INSA-GEI/arm-ada/hardware/Altium-PCB/PCB_Hammond_1591GSGY-v3.PcbDoc.htm

Reporting Options

# File in Previous Format

Date | : | 04/06/2014
Time | : | 15:26:00
Filename | : | D:\Utilisateurs\sd\Mes documents\SVN\arm-ada\Altium-PCB\PCB_Hammond_1591GSGY-v3.PcbDoc

Version | Warning
Release 13 | CAUTION - Silkscreen Over Component Pads Rules are converted to Silk To Solder Mask Clearance Rules. Suggest examining rule scopes for accuracy.
Release 14 | CAUTION - The Differential Pairs Routing rule added support for control of the width. Be aware that Width rules pertaining to differential pairs need to be manually moved to the Differential Pairs Routing rule.

This file was generated by an earlier version of the software
