INSA-GEI/arm-ada/hardware/Altium-PCB/PCB_Hammond_1591GSGY-v2.pdf

100nF | CAP 100nF 16V -20% to +80% 1206 (3216 Metric) Thickness 1mm SMD
1µF | CAP Polarized Tantalum 1µF 3216-18 A
47µF | CAP Polarized Tantalum 47µF 7343-31 D
NDT-03C | Audio HP
SKQUCAA010 | 4 ways + center switch
SPST MicroSwitch | SPST - MicroSwitch
JTAG-10 | 10 way JTAG connector
440247-1 | USB 2.0, Right Angle, SMT, B Type, Receptacle, 5 Position, Black
DM3D-SF | Micro SD card Connector
Inductor | Inductor SMD
POT Type 51 | 25mm Diameter potentiometer
Led | OSRAM LO Q971 Orange
470R
10K | Resistor 10K 0.25W 1% 1206 (3216 Metric) SMD
1K | Resistor 1K 0.25W 1% 1206 (3216 Metric) SMD
22K | Resistor 22K 0.25W 1% 1206 (3216 Metric) SMD
22R | Resistor 22R 0.25W 1% 1206 (3216 Metric) SMD
47K | Resistor 47K 0.25W 1% 1206 (3216 Metric) SMD
1,5K | Resistor 1,5K 0.25W 1% 1206 (3216 Metric) SMD
Not Populated | Resistor 0R 0.25W 1% 1206 (3216 Metric) SMD
TestPoint | TestPoint SMD
STM32F3-DISCOVERY | STM32F3-Discovery Connectors
INT024BTFT | INT024BTFT Connectors
AS64C4008 | SRAM 4Mbits 512K*8Bits 55 ns
TS4990 | TS4990
STM32F102C4T6A | STM32 ARM-based 32-bit MCU Performance Line with 16 kB Flash, 6 kB Internal RAM, Internal Code A, -40 to +85°C Temperature, 48-Pin LQFP, Tray
XC6214 | Fixed LDO regulator
HC49/4H_SMX | Surface Mount Quartz Crystal

Resistor 470R 0,25W 1 % 1206 (3216 Metric) SMD

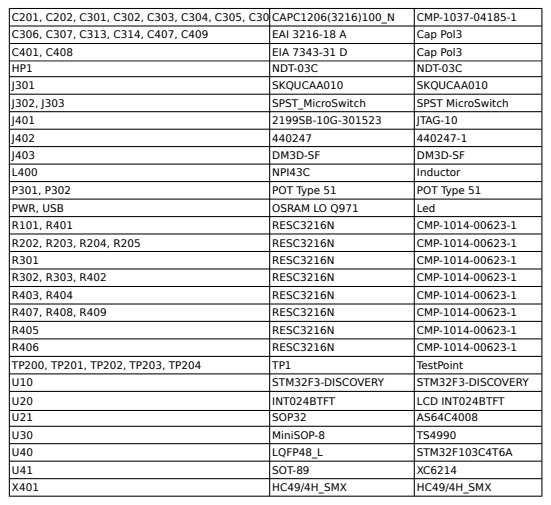
[picture p4: page 2]

18 | KEMET | C1206C104M5RACTU | FARNELL | 1671445
6 | KEMET | B45196H5105K109 | FARNELL | 9753958
2 | KEMET | B45196E1476K409 | FARNELL | 9753770
1 | STAR MICRONICS | NDT-03C | FARNELL | 1299760
1 | ALPS | SKQUCAA010 | RADIOSPARES | 516-316
2 | TE Connectivity | FSM2JH | RADIOSPARES | 479-1390
1 | FCI | 20021121-00010C4LF | FARNELL | 1865279
1 | Molex | 67503-1020 | RADIOSPARES | 666-1099
1 | Hirose | DM3D-SF | RADIOSPARES | 738-8809
1 | NIC Components | NPI43C680MTRF | RADIOSPARES | 740-9429
2 | TE Connectivity | 5150500306 | RADIOSPARES | 393-790P
2 | OSRAM | LO Q971 | RADIOSPARES | 654-5789
2 | YAGEO | RC1206JR-07470RL | FARNELL | 1799533
4 | YAGEO | RC1206JR-0710KL | FARNELL | 2131811
1 | YAGEO | RC1206JR-071KL | FARNELL | 1799519
3 | PANASONIC | ERJ-8GEYJ223V | FARNELL | 2395314
2 | PANASONIC | ERJ-8GEYJ220V | FARNELL | 2395311
3 | PANASONIC | ERJ-8GEYJ473V | FARNELL | 2395337
1 | PANASONIC | ERJ-8GEYJ152V | FARNELL | 2395298
1 | Not populated | Not populated | Not populated | Not populated
5 | N/A | N/A | N/A | N/A
2 | SAMTEC | CES-125-01-T-D | FARNELL | 1667528
2 | SAMTEC | SLW-112-01-G-S | FARNELL | 1668103
1 | ALLIANCE MEMORY | AS6C4008-55SIN | FARNELL | 1562901
1 | STMICROELECTRONICS | TS4990IST | FARNELL | 1750137
1 | STMICROELECTRONICS | STM32F102C4T6A | RADIOSPARES | 723-8956
1 | TOREX | XC6214P332PR | FARNELL | 1698269
1 | TXC | 9C-8.000MEEJ-T | FARNELL | 1842347
