INSA-GEI/arm-ada/docs/Devis - Estimations/Weerg - 50.pdf

€ 2.577,67 (VAT included)
Any customs duties not included

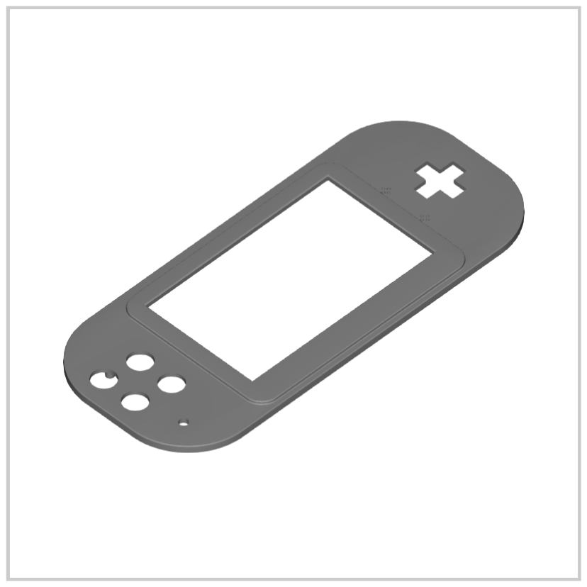
[picture p13: figure]

Partie Haute
DIMENSIONS: 85,00X14,00X200,00mm DELIVERY: mer 10/07/2019
SERVICE STAMPA3D
QUANTITY 50
€ 17,79

Partie basse-slim
DIMENSIONS: 85,00X28,00X200,00mm DELIVERY: mer 10/07/2019
SERVICE STAMPA3D
QUANTITY 50
€ 33,37

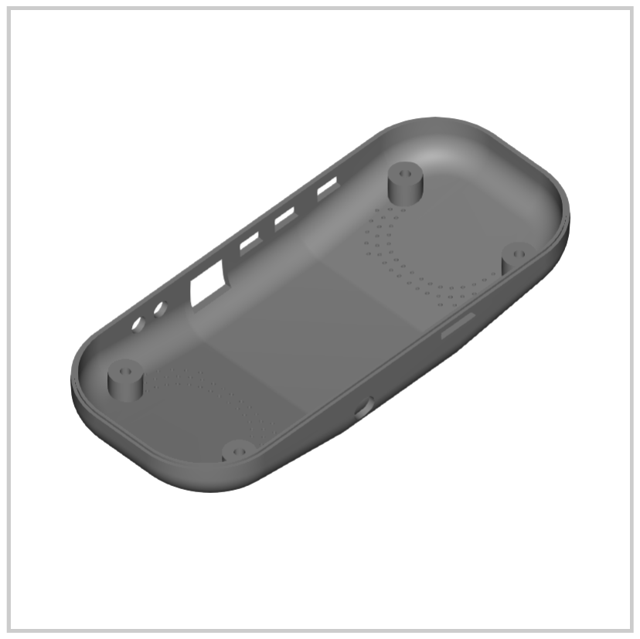
[picture p14: figure]

TOT PRODUCTS | € 2.096,39
Delivery country | FR
TOT DELIVERY DELIV NUM: 1 | € 16,45
TOT NO VAT | € 2.112,84
TOT VAT | € 464,83
TOT.

€ 2.577,67

VALID UNTIL: 25/07/2019
