INSA-GEI/arm-ada/docs/Documentation-technique.odt

Documentation technique

Sébastien DI MERCURIO

1.0

Sommaire

# Présentation

ARM-ADA est un projet composé d’un compilateur et d’un boitier

# Le boîtier « GameBoy »

Un peu de blabla

## Localisation mémoire du bootloader

Stack Data + BSS Buffer USART Code Reservé Le bootloader utilise la mémoire de la façon suivante :

0x10000000

0x10000400

0x10002000

0x20000000

0x2000A000

0x08000000

0x08003000

0x080A0000

0x10001FFC

Données partagées (reboot)

FLASH

RAM

## Localisation mémoire du système

Le système utilise la mémoire de la façon suivante :

Stack Data + BSS Buffer USART Code Reservé

0x10000000

0x10000400

0x10002000

0x20000000

0x2000A000

0x08000000

0x08003000

0x080A0000

0x10001FFC

Données partagées (reboot)

FLASH

RAM

## fdvd

2 - Documentation technique - 1.0

- Documentation technique - 1.0 5
