INSA-GEI/arm-ada/firmware/CubeIDE/System/ressources/INSA_cadrage_serre.jpg

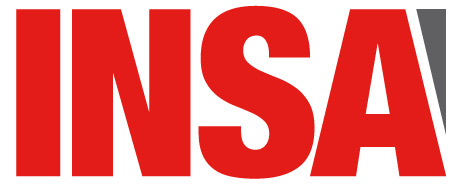
firmware/CubeIDE/System/ressources/INSA_cadrage_serre.jpg
