INSA-GEI/arm-ada/hardware/Altium-PCB/Bill of Material.ods

Composant | Fournisseur | Ref Fournisseur | Ref fabriquant | Prix unitaire | Quantité | Sous Total
Connecteurs STM32F3-Discovery | Farnell | 166-7528 | CES-125-01-T-D | 2.64 | 2
Connecteurs Ecran LCD femelle | Farnell | 166-8103 | SLW-112-01-G-S | 1.93 | 2
Haut Parleur | Farnell | 129-9760 | NDT-03C | 3.19 | 1
RAM | Farnell | 1562901 | AS6C4008-55SIN | 2.72 | 1
Potentiometres | Farnell | 117-4445 | 5150500307 | 1.18 | 2
Bouton potentiometre | Farnell | 748330 | 5904620121 | 0.8 | 2
Connecteurs Ecran LCD male | Farnell | 203-5399 | TSW-112-06-T-S | 0.763 | 2
Connecteur debug | Farnell | 186-5279 | 20021121-00010C4LF | 0.84 | 1
Ampli audio | Farnell | 175-0137 | TS4990IST | 0.54 | 1
Quartz | Farnell | 1842347 | TXC - 9C-8.000MEEJ-T | 0.32 | 1
Bouton | Radiospares | 479-1390 | FSM2JH | 0.1 | 2
Regulateur 3,3V | Farnell | 1698269 | XC6214P332PR | 0.36 | 1
Écran LCD | Radiospares | 740-6008 | INT24BTFT | 31.185 | 1
STM32F3-Discovery | Radiospares | 769-2091 | STM32F3-Discovery | 10.044 | 1
Boitier | Radiospares | 493-6183 | 1590GGY | 4.527 | 1
STM32F102C4T6A | Radiospares | 723-8956 | STM32F102C4T6A | 2.223 | 1
Bouton 5 directions | Radiospares | 516-316 | SKQUCAA010 | 1.728 | 1
Connecteur MicroSD | Radiospares | 738-8809 | DM3D-SF | 1.012 | 1
Connecteur Mini USB | Radiospares | 666-1099 | 67503-1020 | 0.421 | 1
Entretoises PVC | Radiospares | 265-2170 |  |  | 4
Vis LCD | Radiospares | 482-7887 |  |  | 4
Led | Radiospares | 654-5789 | LO Q971 | 0.038 | 2
Vis PCB | Radiospares | 482-8262 |  |  | 4
Inductance CMS 68µH | Radiospares | 740-9429 | NPI43C680MTRF | 0.184 | 1
Ecrous LCD | Radiospares | 248-4567 |  |  | 4
Rondelles LCD | Radiospares | 289-073 |  |  | 4
PCB | PCB_Pool |  |  | 6.5 | 1
 |  |  |  |  | Total HT =>
 |  |  |  |  | TVA
 |  |  |  |  | Total TTC =>
