INSA-GEI/arm-ada/hardware/Altium-PCB/PCB_Hammond_1591GSGY-v2.xls

Comment | Description | Designator | Footprint | LibRef | Quantity | Manufacturer | Manufacturer Ref | Distributor | Distributor Ref
100nF | CAP 100nF 16V -20% to +80% 1206 (3216 Metric) Thickness 1mm SMD | C201, C202, C301, C302, C303, C304, C305, C308, C309, C310, C311, C312, C402, C403, C404, C405, C406, C410 | CAPC1206(3216)100_N | CMP-1037-04185-1 | 18 | KEMET | C1206C104M5RACTU | FARNELL | 1671445
1µF | CAP Polarized Tantalum 1µF 3216-18 A | C306, C307, C313, C314, C407, C409 | EAI 3216-18 A | Cap Pol3 | 6 | KEMET | B45196H5105K109 | FARNELL | 9753958
47µF | CAP Polarized Tantalum 47µF 7343-31 D | C401, C408 | EIA 7343-31 D | Cap Pol3 | 2 | KEMET | B45196E1476K409 | FARNELL | 9753770
NDT-03C | Audio HP | HP1 | NDT-03C | NDT-03C | 1 | STAR MICRONICS | NDT-03C | FARNELL | 1299760
SKQUCAA010 | 4 ways + center switch | J301 | SKQUCAA010 | SKQUCAA010 | 1 | ALPS | SKQUCAA010 | RADIOSPARES | 516-316
SPST MicroSwitch | SPST - MicroSwitch | J302, J303 | SPST_MicroSwitch | SPST MicroSwitch | 2 | TE Connectivity | FSM2JH | RADIOSPARES | 479-1390
JTAG-10 | 10 way JTAG connector | J401 | 2199SB-10G-301523 | JTAG-10 | 1 | FCI | 20021121-00010C4LF | FARNELL | 1865279
440247-1 | USB 2.0, Right Angle, SMT, B Type, Receptacle, 5 Position, Black | J402 | 440247 | 440247-1 | 1 | Molex | 67503-1020 | RADIOSPARES | 666-1099
DM3D-SF | Micro SD card Connector | J403 | DM3D-SF | DM3D-SF | 1 | Hirose | DM3D-SF | RADIOSPARES | 738-8809
Inductor | Inductor SMD | L400 | NPI43C | Inductor | 1 | NIC Components | NPI43C680MTRF | RADIOSPARES | 740-9429
POT Type 51 | 25mm Diameter potentiometer | P301, P302 | POT Type 51 | POT Type 51 | 2 | TE Connectivity | 5150500306 | RADIOSPARES | 393-790P
Led | OSRAM LO Q971 Orange | PWR, USB | OSRAM LO Q971 | Led | 2 | OSRAM | LO Q971 | RADIOSPARES | 654-5789
470R | Resistor 470R 0,25W 1 % 1206 (3216 Metric) SMD | R101, R401 | RESC3216N | CMP-1014-00623-1 | 2 | YAGEO | RC1206JR-07470RL | FARNELL | 1799533
10K | Resistor 10K 0.25W 1% 1206 (3216 Metric) SMD | R202, R203, R204, R205 | RESC3216N | CMP-1014-00623-1 | 4 | YAGEO | RC1206JR-0710KL | FARNELL | 2131811
1K | Resistor 1K 0.25W 1% 1206 (3216 Metric) SMD | R301 | RESC3216N | CMP-1014-00623-1 | 1 | YAGEO | RC1206JR-071KL | FARNELL | 1799519
22K | Resistor 22K 0.25W 1% 1206 (3216 Metric) SMD | R302, R303, R402 | RESC3216N | CMP-1014-00623-1 | 3 | PANASONIC | ERJ-8GEYJ223V | FARNELL | 2395314
22R | Resistor 22R 0.25W 1% 1206 (3216 Metric) SMD | R403, R404 | RESC3216N | CMP-1014-00623-1 | 2 | PANASONIC | ERJ-8GEYJ220V | FARNELL | 2395311
47K | Resistor 47K 0.25W 1% 1206 (3216 Metric) SMD | R407, R408, R409 | RESC3216N | CMP-1014-00623-1 | 3 | PANASONIC | ERJ-8GEYJ473V | FARNELL | 2395337
1,5K | Resistor 1,5K 0.25W 1% 1206 (3216 Metric) SMD | R405 | RESC3216N | CMP-1014-00623-1 | 1 | PANASONIC | ERJ-8GEYJ152V | FARNELL | 2395298
Not Populated | Resistor 0R 0.25W 1% 1206 (3216 Metric) SMD | R406 | RESC3216N | CMP-1014-00623-1 | 1 | Not populated | Not populated | Not populated | Not populated
TestPoint | TestPoint SMD | TP200, TP201, TP202, TP203, TP204 | TP1 | TestPoint | 5 | N/A | N/A | N/A | N/A
STM32F3-DISCOVERY | STM32F3-Discovery Connectors | U10 | STM32F3-DISCOVERY | STM32F3-DISCOVERY | 2 | SAMTEC | CES-125-01-T-D | FARNELL | 1667528
INT024BTFT | INT024BTFT Connectors | U20 | INT024BTFT | LCD INT024BTFT | 2 | SAMTEC | SLW-112-01-G-S | FARNELL | 1668103
AS64C4008 | SRAM 4Mbits 512K*8Bits 55 ns | U21 | SOP32 | AS64C4008 | 1 | ALLIANCE MEMORY | AS6C4008-55SIN | FARNELL | 1562901
TS4990 | TS4990 | U30 | MiniSOP-8 | TS4990 | 1 | STMICROELECTRONICS | TS4990IST | FARNELL | 1750137
STM32F102C4T6A | STM32 ARM-based 32-bit MCU Performance Line with 16 kB Flash, 6 kB Internal RAM, Internal Code A, -40 to +85°C Temperature, 48-Pin LQFP, Tray | U40 | LQFP48_L | STM32F103C4T6A | 1 | STMICROELECTRONICS | STM32F102C4T6A | RADIOSPARES | 723-8956
XC6214 | Fixed LDO regulator | U41 | SOT-89 | XC6214 | 1 | TOREX | XC6214P332PR | FARNELL | 1698269
HC49/4H_SMX | Surface Mount Quartz Crystal | X401 | HC49/4H_SMX | HC49/4H_SMX | 1 | TXC | 9C-8.000MEEJ-T | FARNELL | 1842347
