INSA-GEI/arm-ada/hardware/Altium-PCB/Meca/1591G Lid.stp

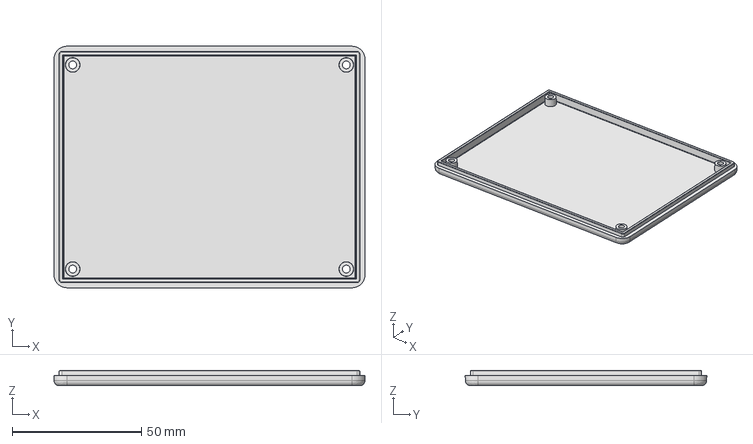
[picture p34: CAD file, 2021-03-29]
hardware/Altium-PCB/Meca/1591G Lid.stp
120.5 x 93.6 x 6.00 mm
