INSA-GEI/arm-ada/hardware/Altium-PCB/Meca/pcb.stp

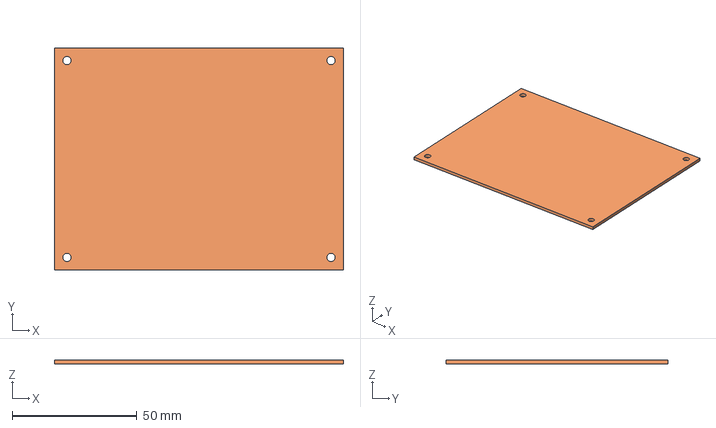
[picture p35: CAD file, 2021-03-29]
hardware/Altium-PCB/Meca/pcb.stp
116.0 x 89.0 x 1.60 mm
