INSA-GEI/arm-ada/hardware/Altium-PCB/Meca/1591G Box.stp

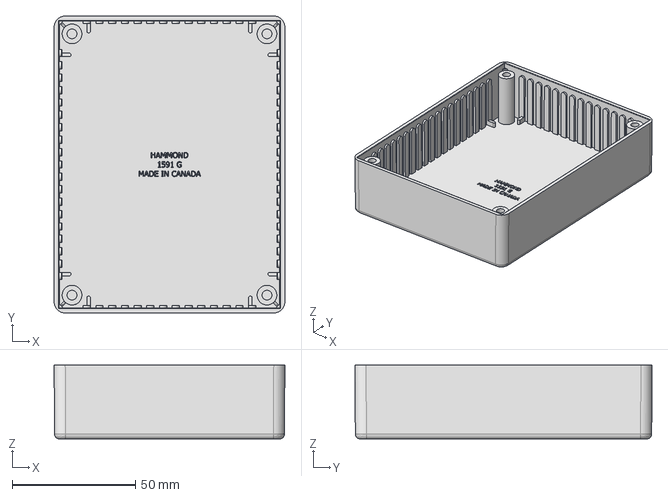
[picture p36: CAD file, 2021-03-29]
hardware/Altium-PCB/Meca/1591G Box.stp
93.6 x 120.5 x 30.0 mm
