INSA-GEI/arm-ada/(list of files, cad)

Other CAD files:
hardware/Altium-PCB/Meca/1591G Box.igs
hardware/Altium-PCB/Meca/1591G Box.ipt
hardware/Altium-PCB/Meca/1591G Lid.igs
hardware/Altium-PCB/Meca/Boitier + PCB.iam
hardware/Altium-PCB/Meca/Boitier.ipt
hardware/Altium-PCB/Meca/Composants importés/1591G Box/1591G Box.ipt
hardware/Altium-PCB/Meca/Insert.ipt
hardware/Altium-PCB/Meca/OldVersions/Boitier + PCB.0001.iam
hardware/Altium-PCB/Meca/OldVersions/Boitier.0001.ipt
hardware/Altium-PCB/Meca/OldVersions/Insert.0001.ipt
hardware/Altium-PCB/Meca/OldVersions/pcb.0002.ipt
hardware/Altium-PCB/Meca/boitier.iam
hardware/Altium-PCB/Meca/pcb.dwg
hardware/Altium-PCB/Meca/pcb.idw
hardware/Altium-PCB/Meca/pcb.ipt
