INSA-GEI/arm-ada/hardware/Altium-PCB/Ada4Arm.pdf

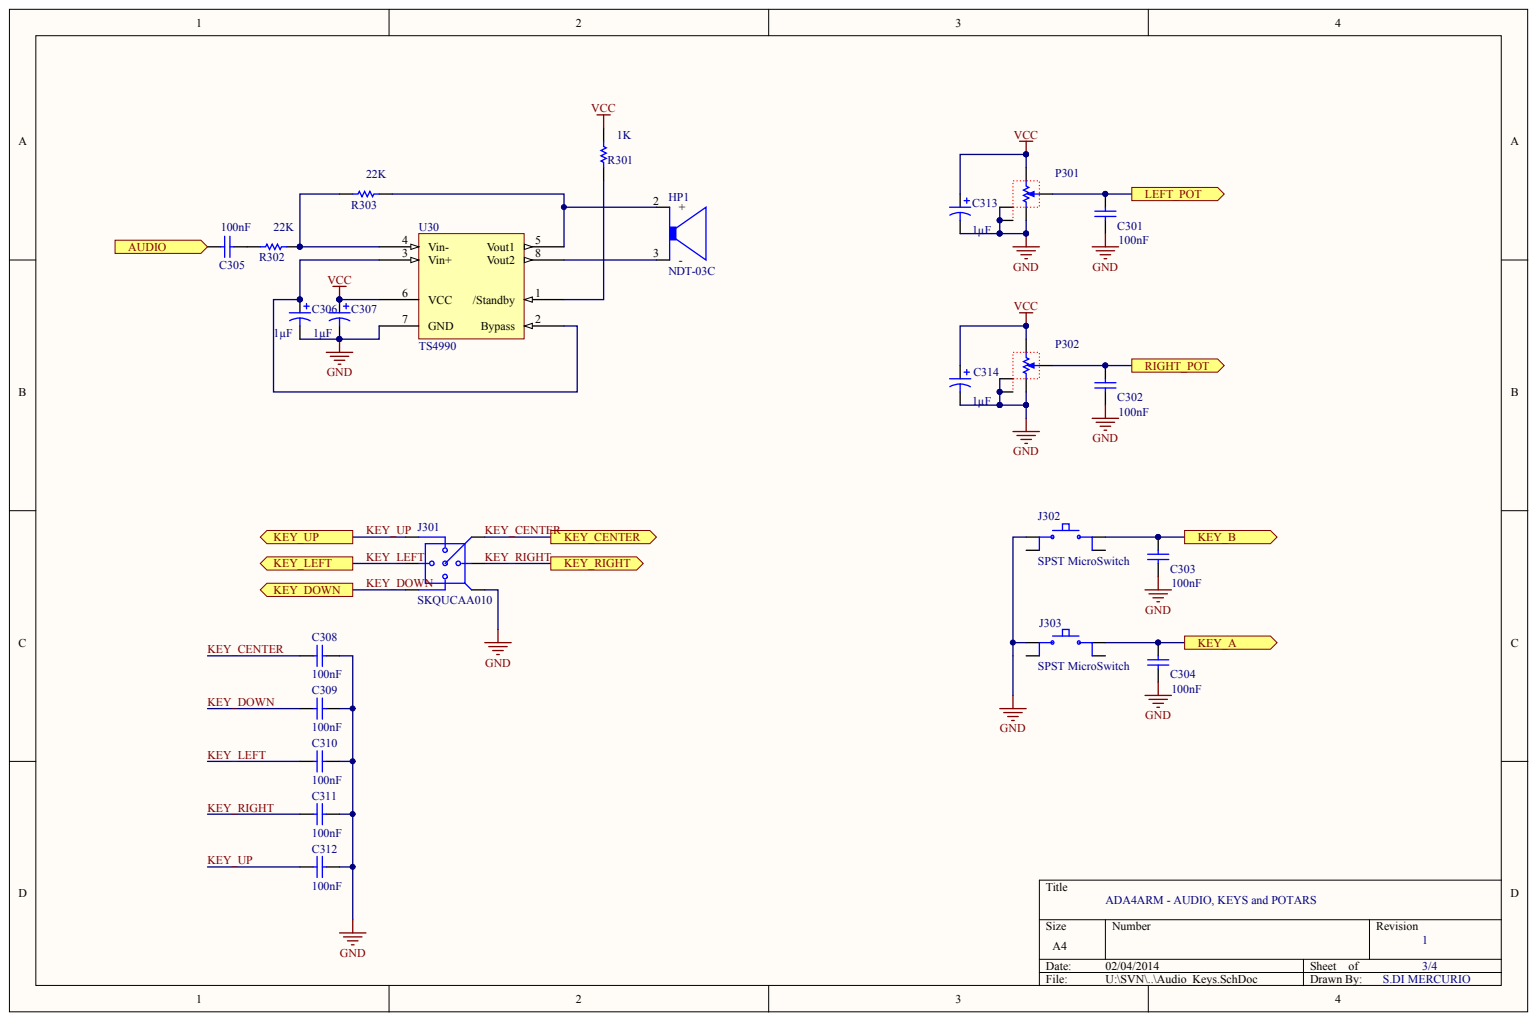
[picture p37: page 1]

ADA4ARM - AUDIO, KEYS and POTARS

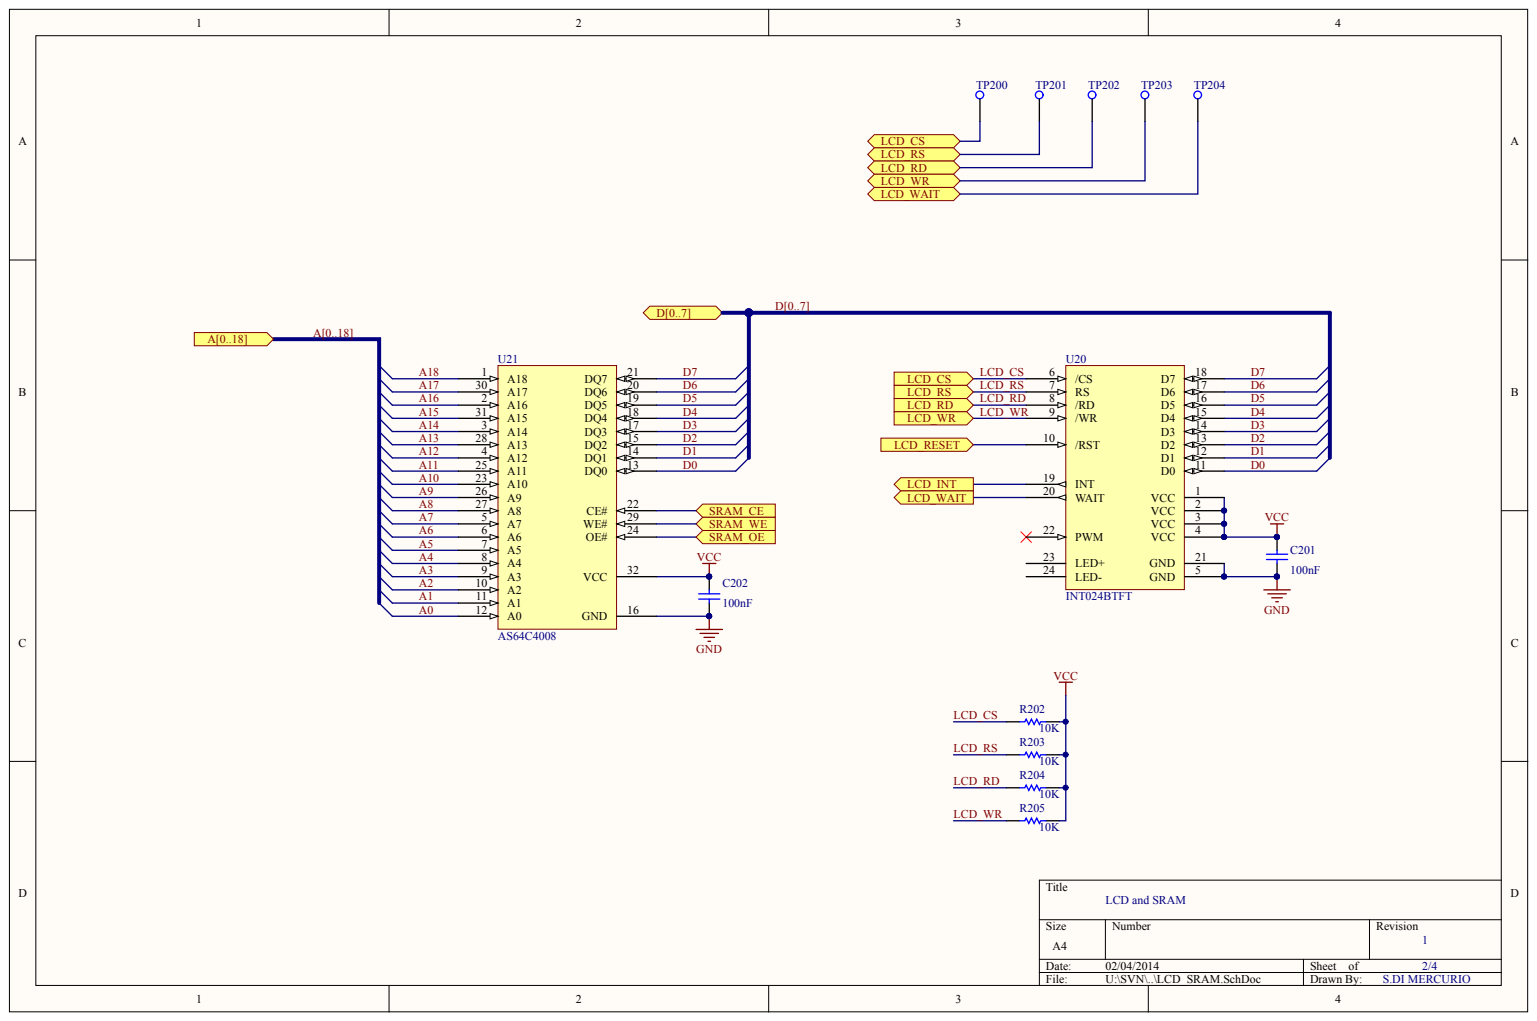
[picture p38: page 2]

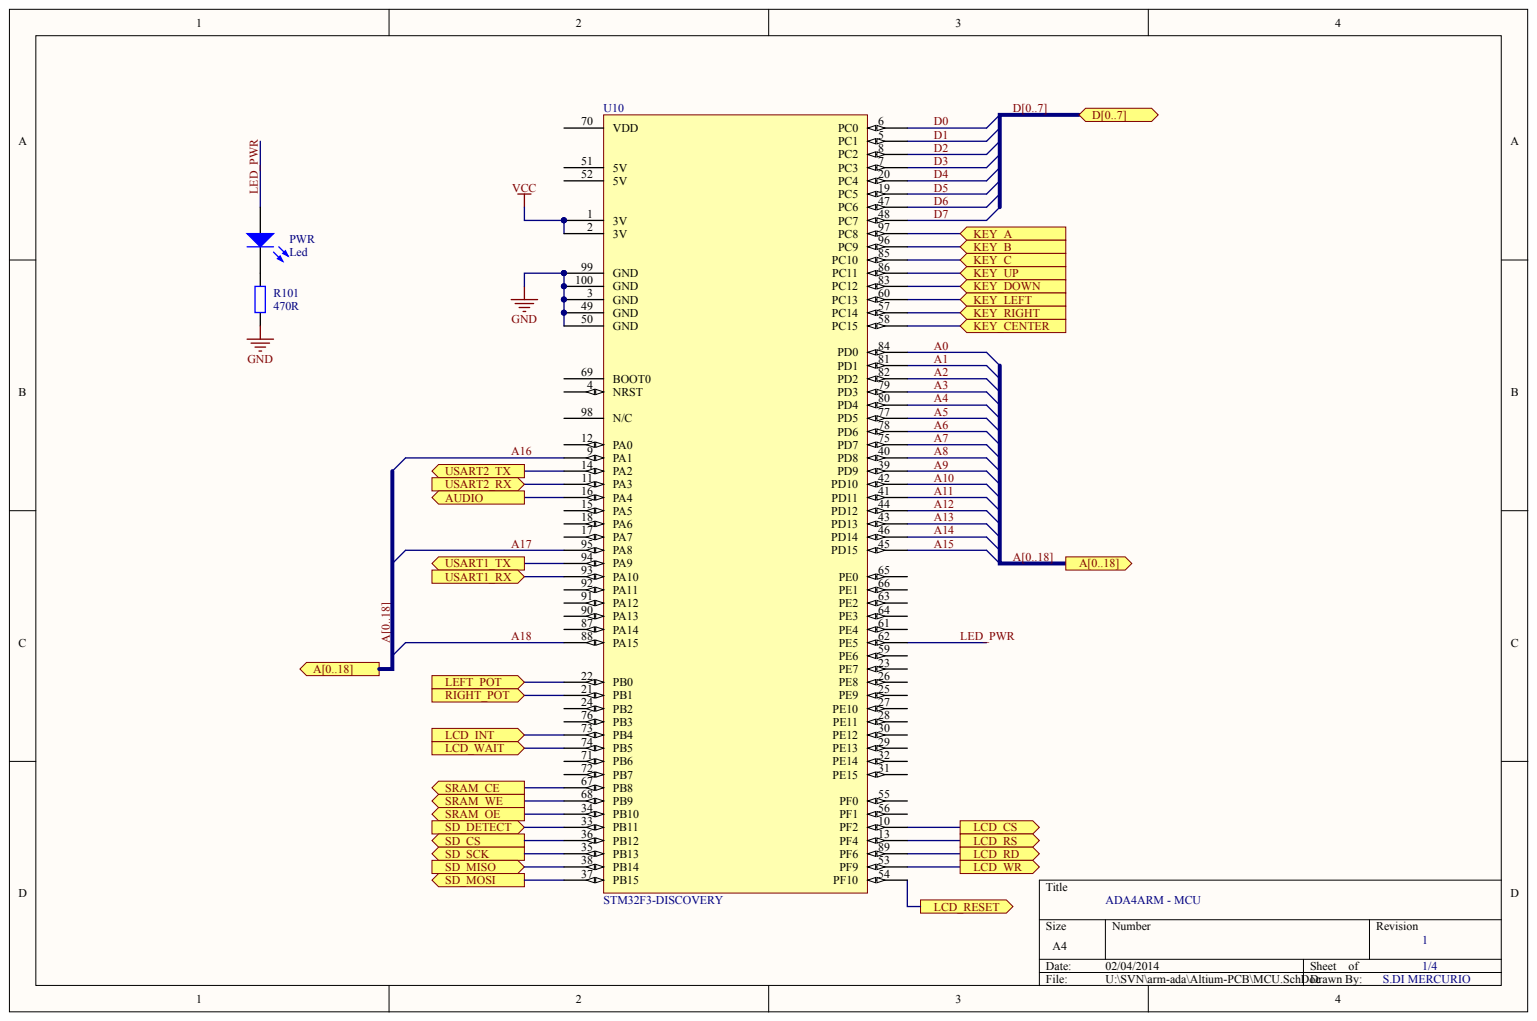
[picture p39: page 3]

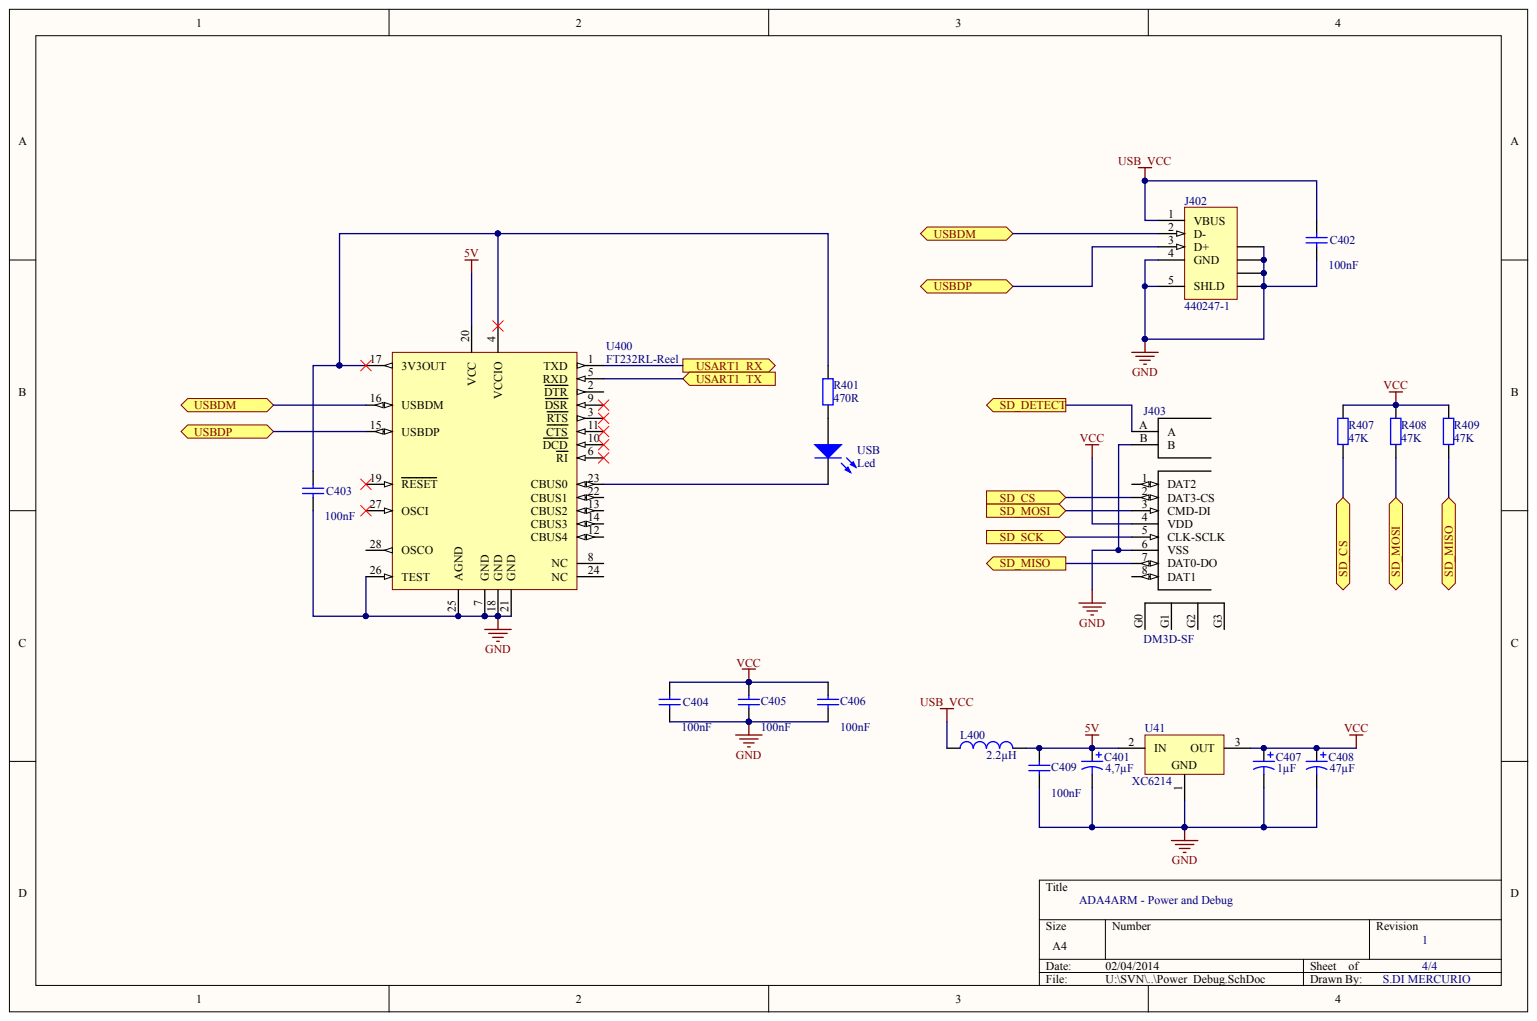
[picture p40: page 4]

4 | GND SHLD

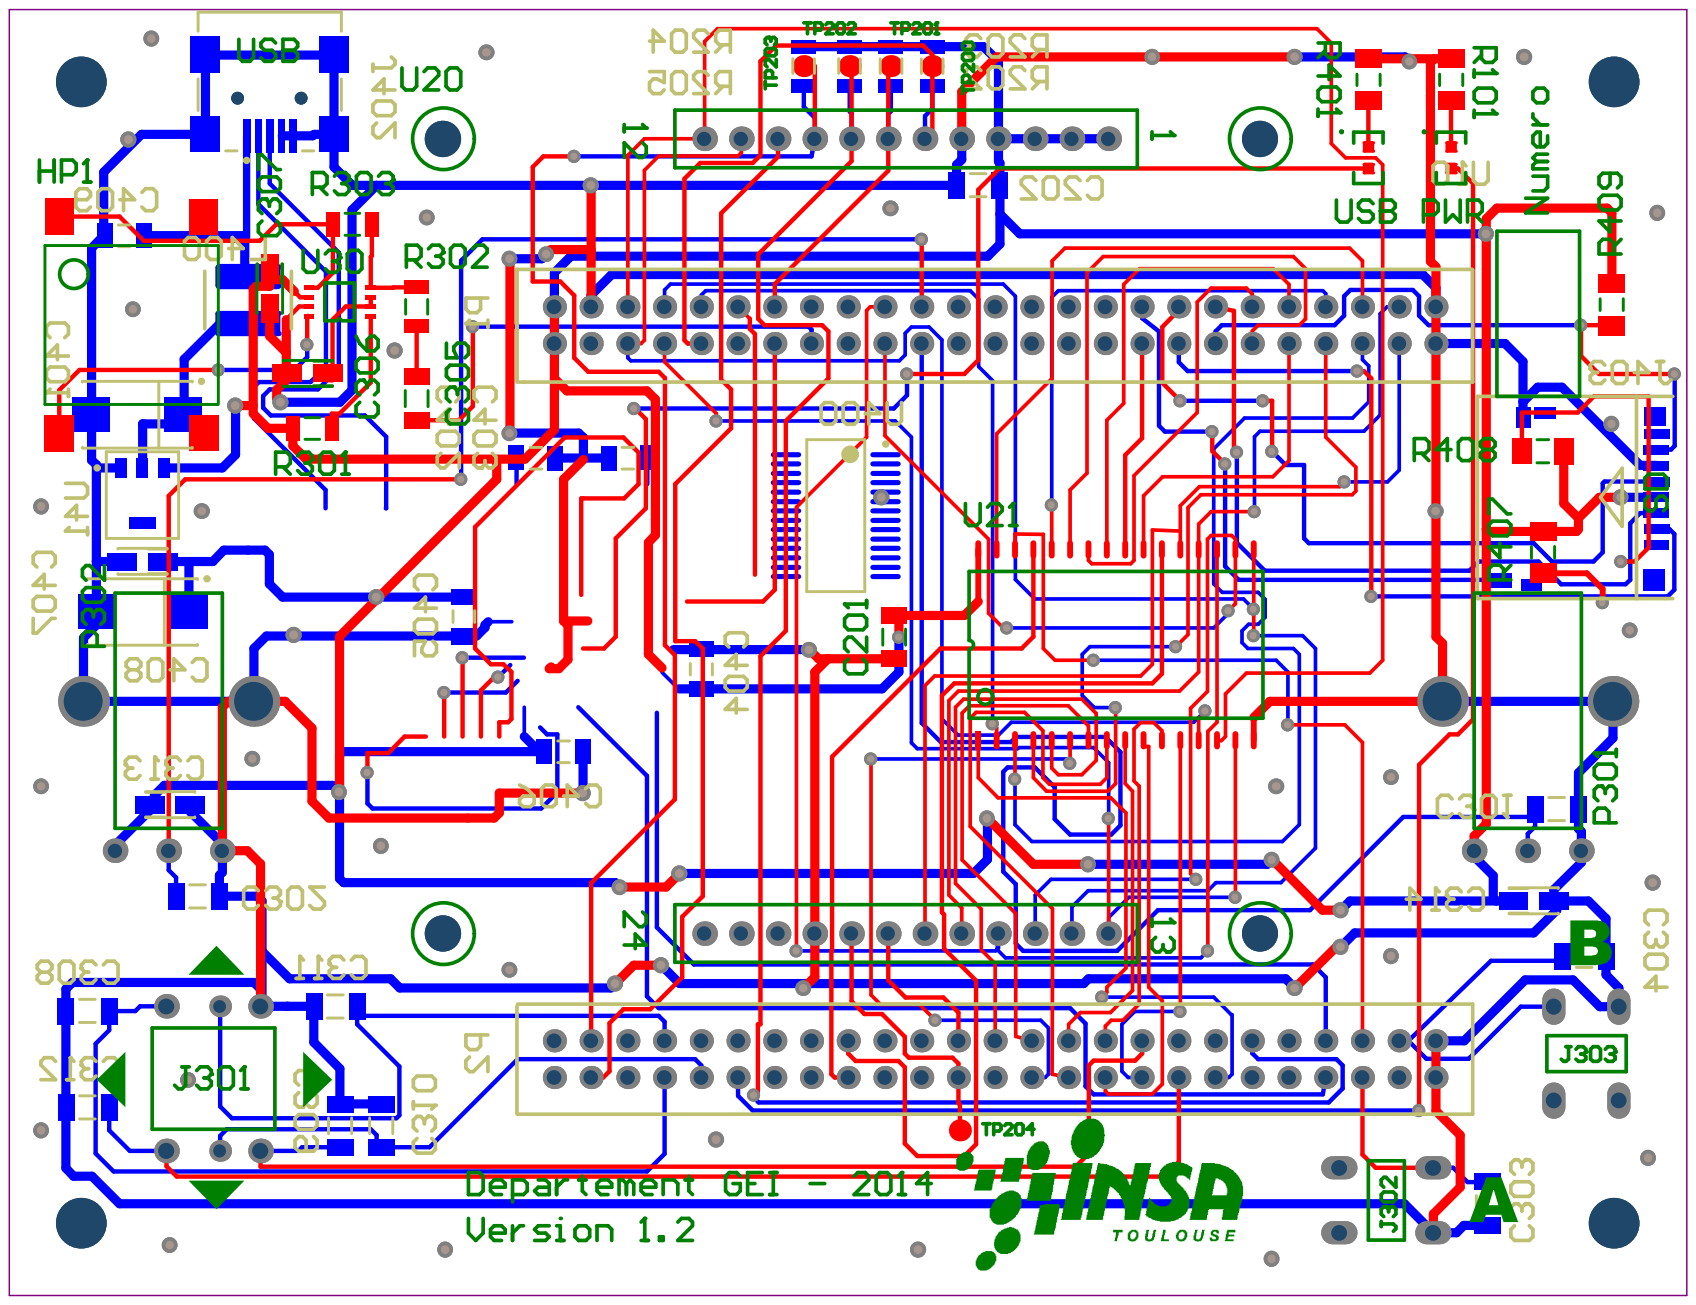
[picture p41: page 5]
