INSA-GEI/arm-ada/hardware/Altium-PCB/PCB_Hammond_1591GSGY.PDF

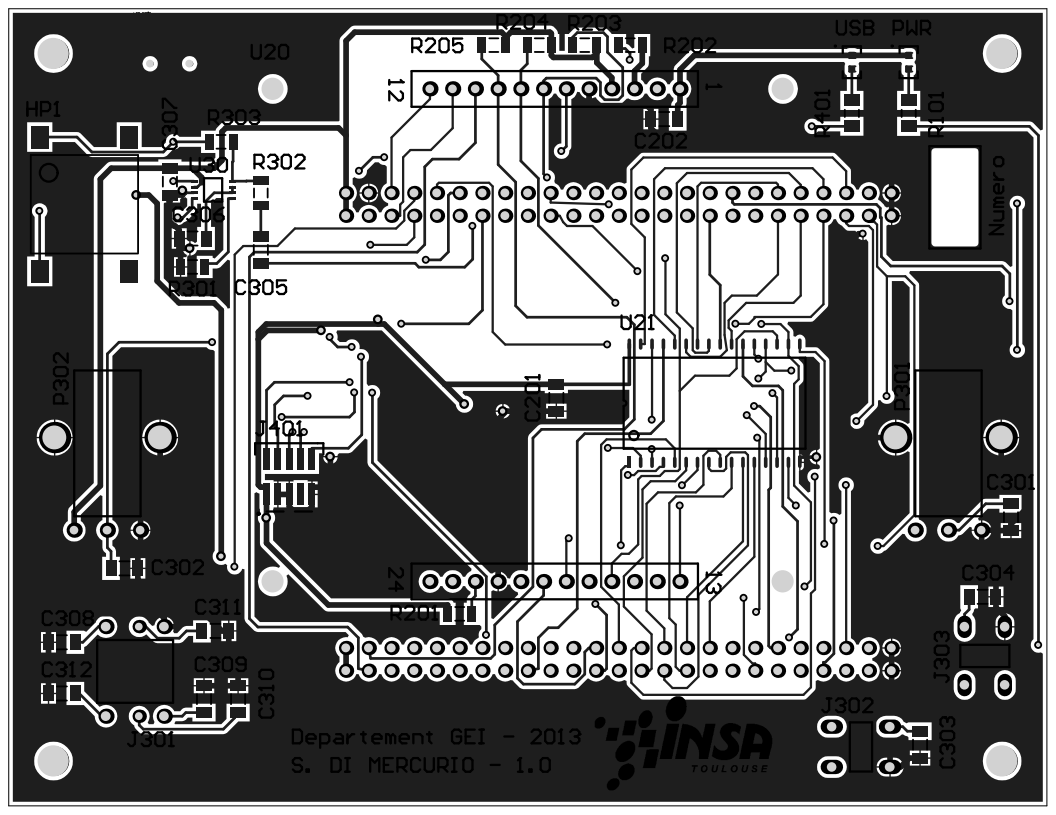
[picture p42: page 1]

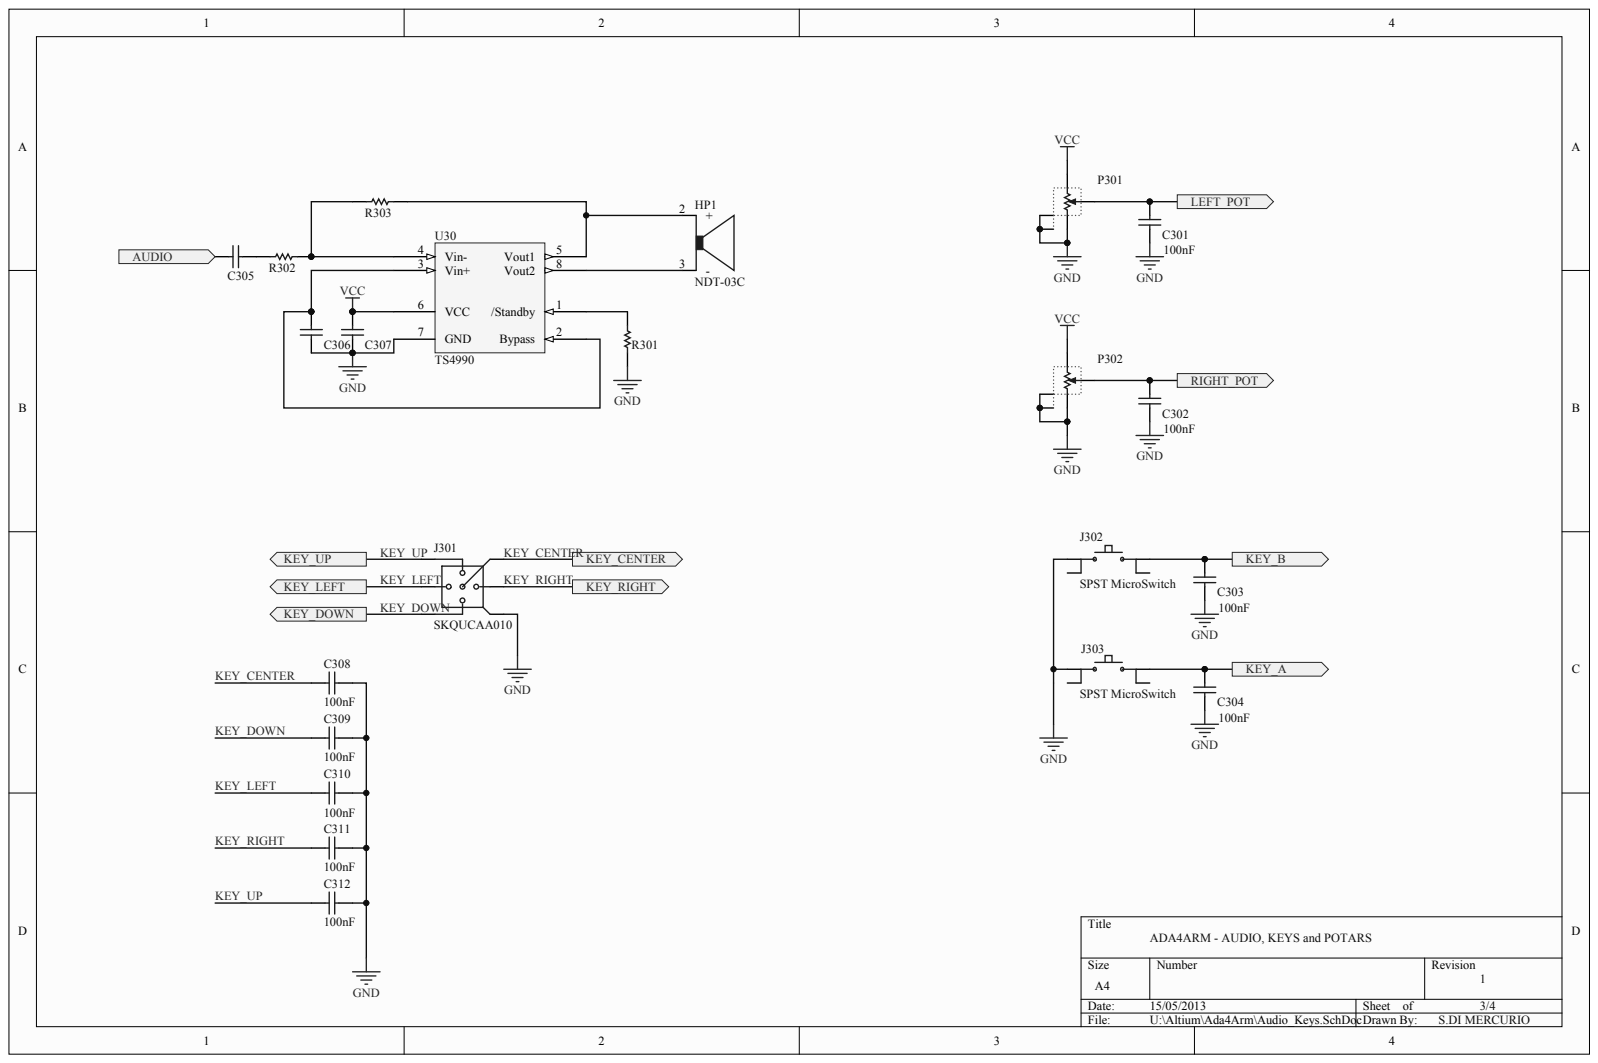
[picture p43: page 2]

ADA4ARM - AUDIO, KEYS and POTARS

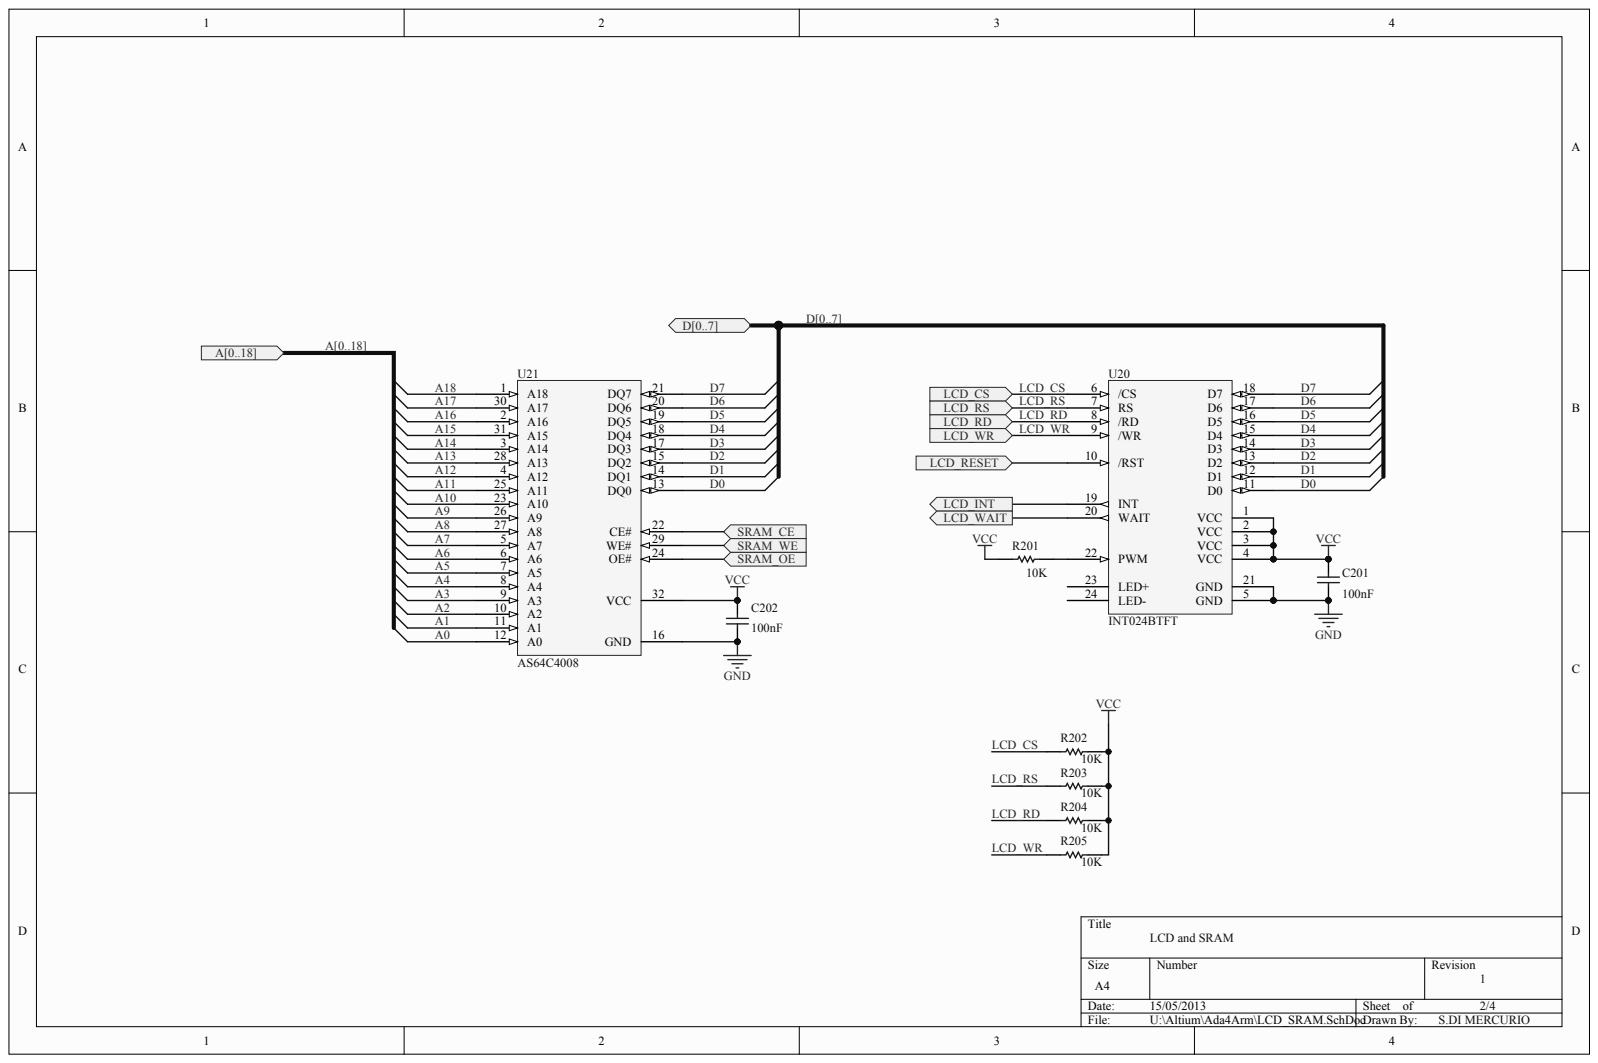
[picture p44: page 3]

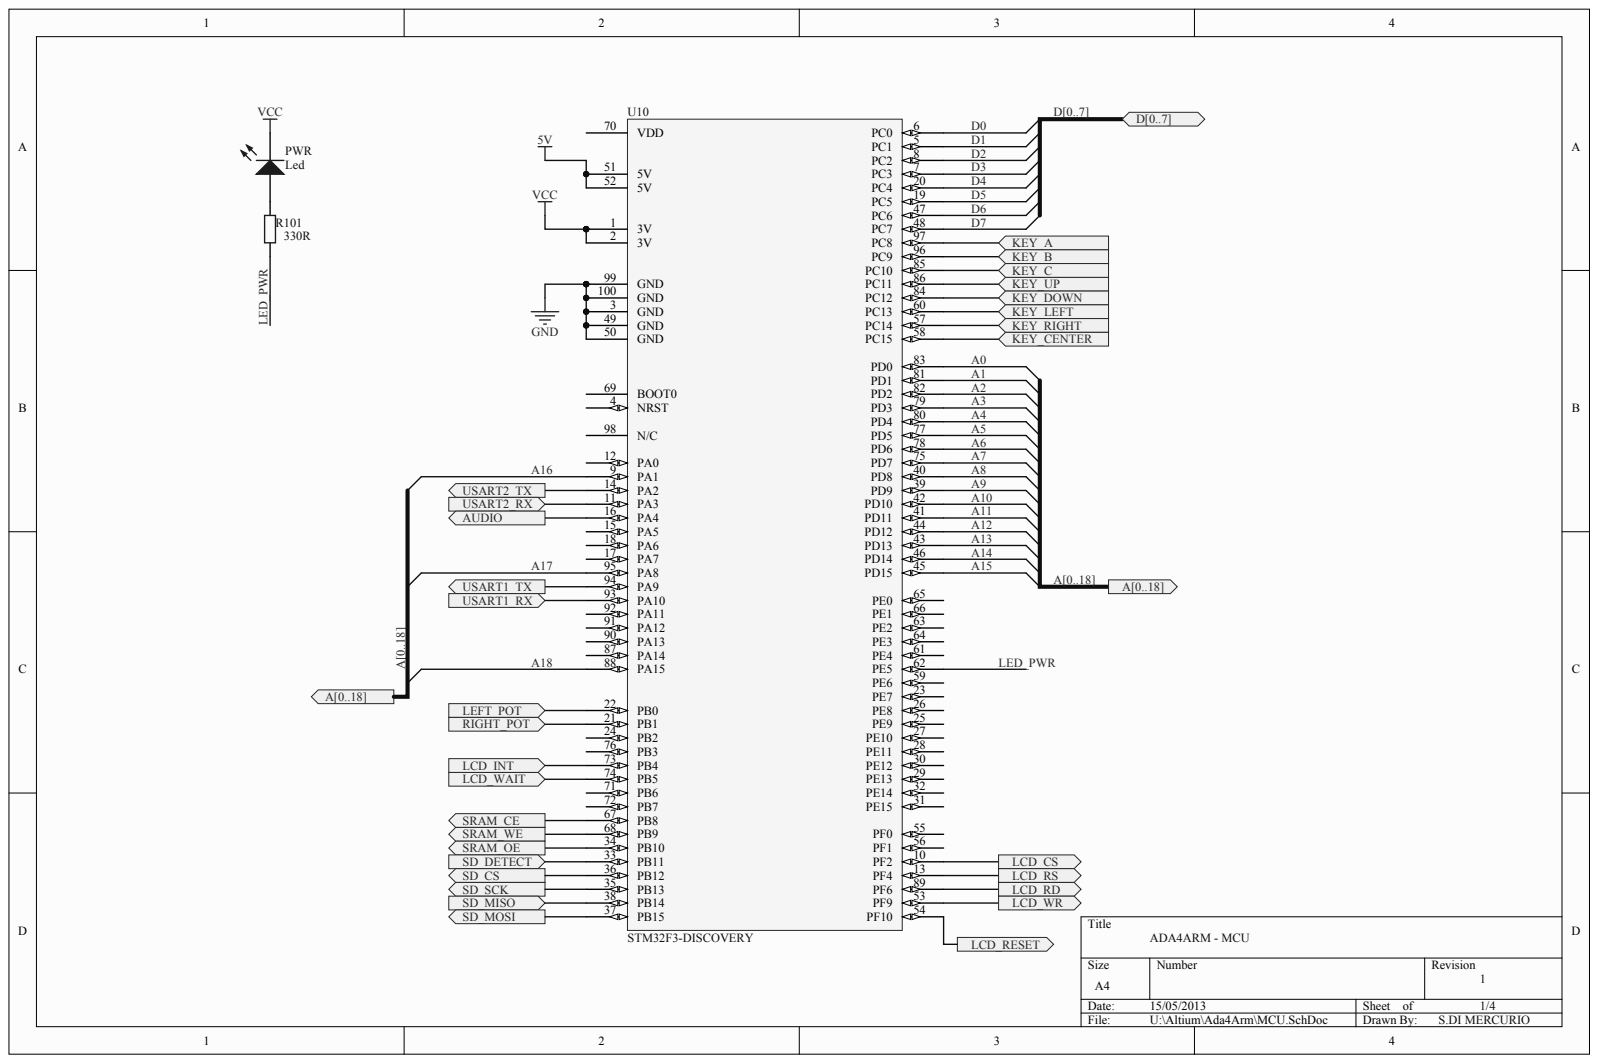
[picture p45: page 4]

GND 100

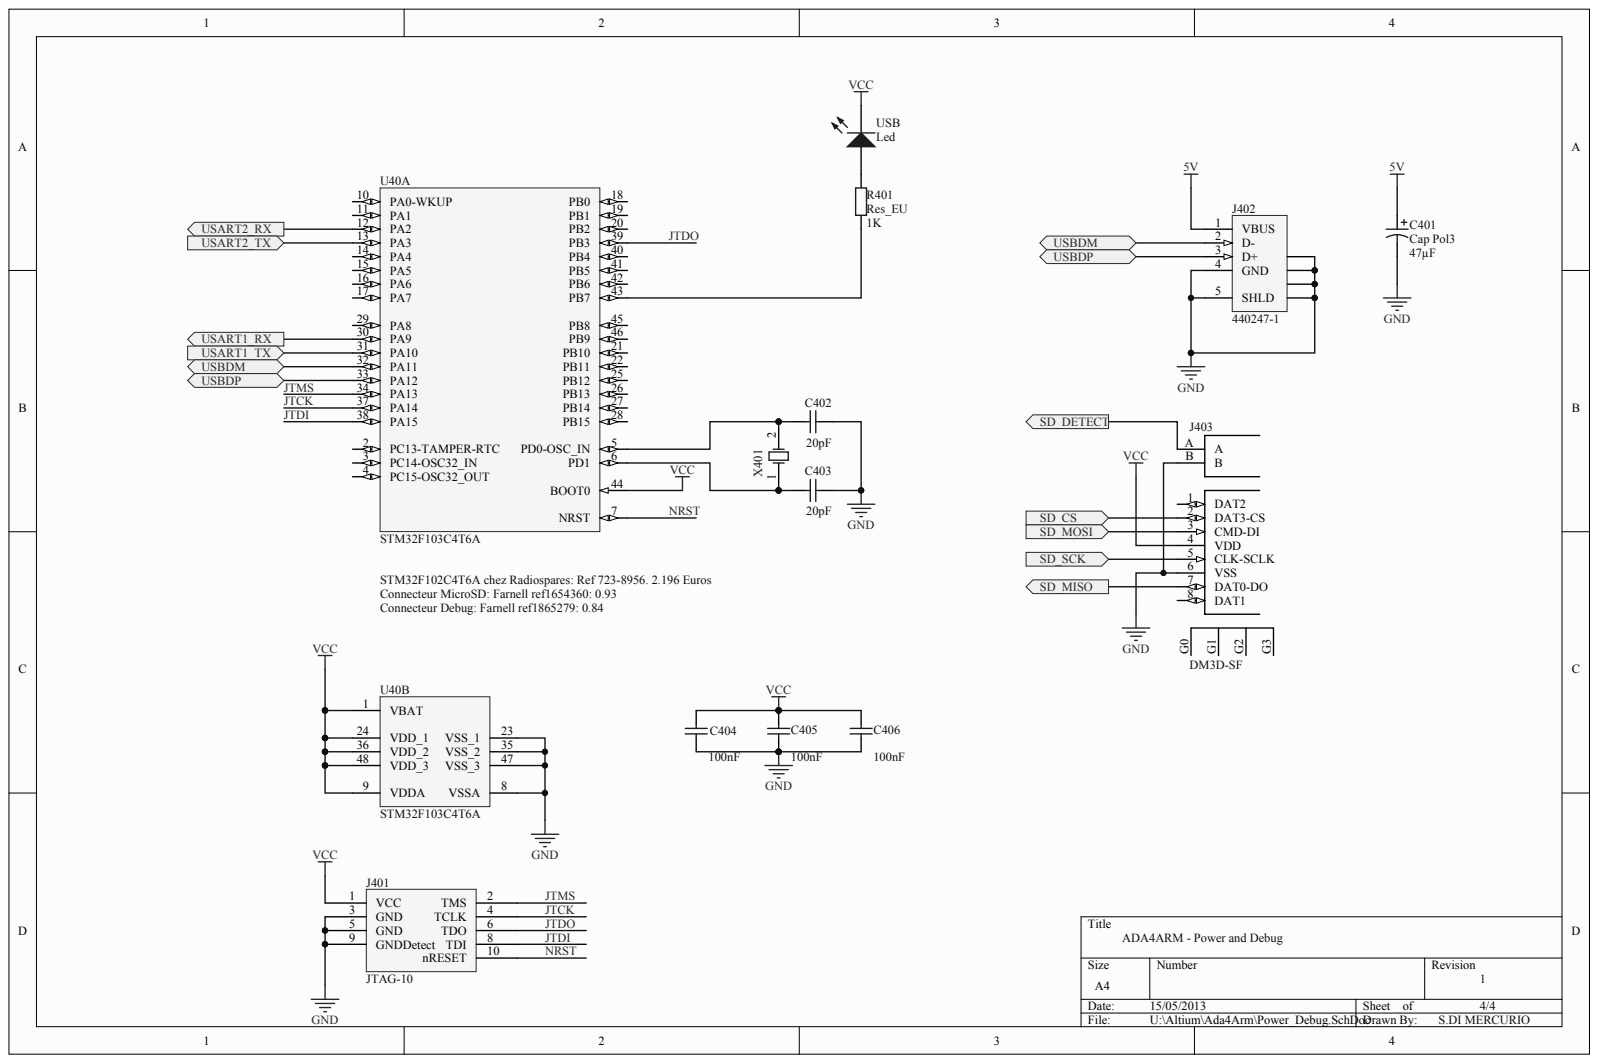
[picture p46: page 5]

CMD-DI 3
VDD 4
CLK-SCLK 5
VSS 6
DAT0-DO 7
DAT1 8

STM32F102C4T6A chez Radiospares: Ref 723-8956. 2.196 Euros
Connecteur MicroSD: Farnell ref1654360: 0.93
Connecteur Debug: Farnell ref1865279: 0.84
