INSA-GEI/arm-ada/hardware/Altium-PCB/Project Outputs for Ada4Arm/PCB_Hammond_1591GSGY.PDF

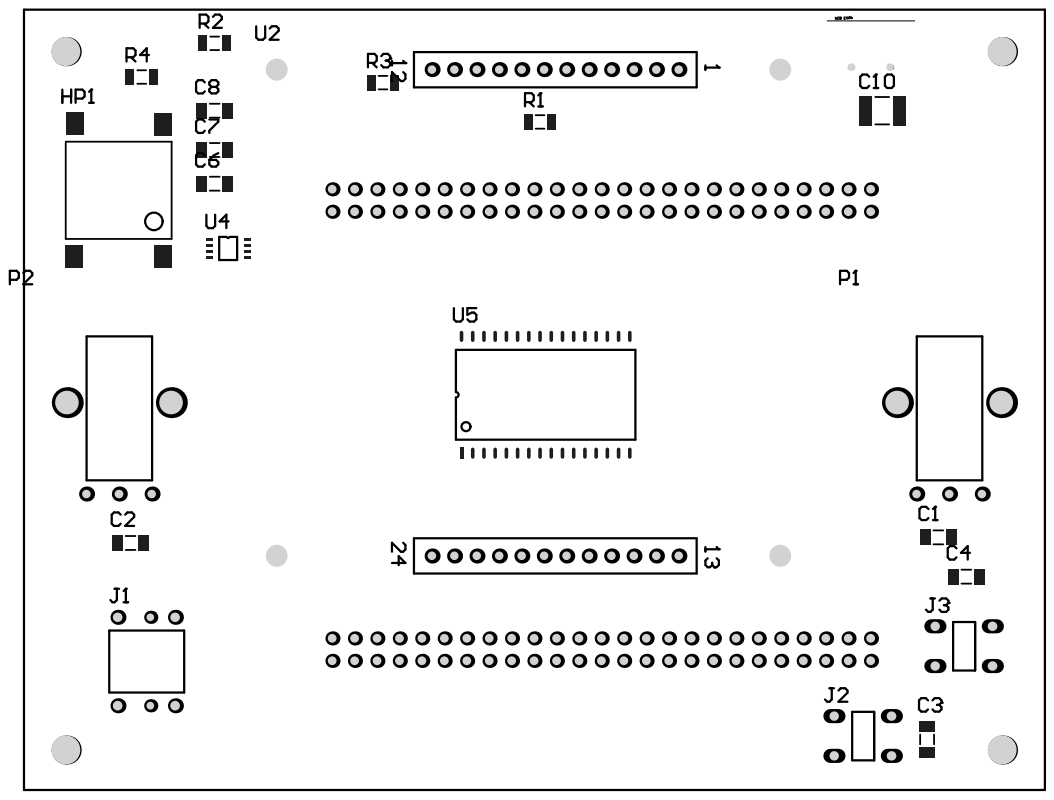
[picture p47: page 1]
