INSA-GEI/arm-ada/(list of files, drawings)

Other design files:
hardware/Altium-PCB/Ada4Arm.PcbDoc
hardware/Altium-PCB/Ada4Arm.PrjPCB
hardware/Altium-PCB/Ada4Arm.SchDoc
hardware/Altium-PCB/Audio_Keys.SchDoc
hardware/Altium-PCB/LCD_SRAM.SchDoc
hardware/Altium-PCB/MCU.SchDoc
hardware/Altium-PCB/PCB1.PcbDoc
hardware/Altium-PCB/PCB2.PcbDoc
hardware/Altium-PCB/PCB_Hammond_1591GSGY-test2.PcbDoc
hardware/Altium-PCB/PCB_Hammond_1591GSGY-test.PcbDoc
hardware/Altium-PCB/PCB_Hammond_1591GSGY-v2-good.PcbDoc
hardware/Altium-PCB/PCB_Hammond_1591GSGY-v2.PcbDoc
hardware/Altium-PCB/PCB_Hammond_1591GSGY-v3.PcbDoc
hardware/Altium-PCB/PCB_Hammond_1591GSGY-v3B.PcbDoc
hardware/Altium-PCB/PCB_Hammond_1591GSGY.PcbDoc
hardware/Altium-PCB/Power_Debug.SchDoc
hardware/Altium-PCB/Simu/Alim.SchDoc
hardware/Altium-PCB/Simu/Simu.PrjPCB
