INSA-GEI/arm-ada/(commit log)

2021-03-26 initial commit sur master, correspondant au l'utilisation de gnatstudio et du profil zfs
    [ARM-ADA-NG-1.csv, BOM_carte_principale_ENG.xlsx, Button-SNES.ipt, Button.ipt, Button.stl, Button.stp, Cross.ipt, Cross.stl]
2021-03-26 commit version 2.13 de la branche legacy du firmware v2
    [ARM-ADA-NG-1.csv, BOM_carte_principale_ENG.xlsx, Button-SNES.ipt, Button.ipt, Button.stl, Button.stp, Cross.ipt, Cross.stl]
2021-03-29 Import du depot de la console v1
    [1591G Box.igs, 1591G Box.ipt, 1591G Box.stp, 1591G Lid.igs, 1591G Lid.stp, Ada4Arm.PcbDoc, Ada4Arm.PrjPCB, Ada4Arm.SchDoc]
